Korb-Modular/02_FOLDER/05_Docs/BOM FOLDER Ver1.0.xlsx

BOM: FOLDER Ver1.0
Qty | Value | Device | Package | Parts | Description | Mouser
Resistors
9 | 100 | R-EU_R0603 | R0603 | R2, R4, R18, R23, R118, R158, R159, R160, R161 | RESISTOR, European symbol | 667-ERJ-3EKF1000V
3 | 475 | R-EU_R0603 | R0603 | R19, R62, R157 | RESISTOR, European symbol | 667-ERJ-3EKF4750V
1 | 680 | R-EU_R0603 | R0603 | R130 | RESISTOR, European symbol | 667-ERJ-3EKF6800V
10 | 1k | R-EU_R0603 | R0603 | R22, R26, R34, R49, R51, R81, R89, R95, R109, R114 | RESISTOR, European symbol | 667-ERJ-3EKF1001V
2 | 2k | R-EU_0204/7 | 0204/7 | R24, R55 | Tempco Resistor – 1% 3300ppm | e.g. THONK
6 | 2k | R-EU_R0603 | R0603 | R3, R33, R39, R46, R80, R96 | RESISTOR, European symbol | 667-ERJ-3EKF2001V
1 | 2,67k | R-EU_R0603 | R0603 | R141 | RESISTOR, European symbol | 667-ERJ-3EKF2671V
2 | 3k | R-EU_R0603 | R0603 | R41, R103 | RESISTOR, European symbol | 667-ERJ-3EKF3001V
6 | 4,7k | R-EU_R0603 | R0603 | R9, R36, R52, R65, R102, R112 | RESISTOR, European symbol | 667-ERJ-3EKF4701V
2 | 5,62k | R-EU_R0603 | R0603 | R152, R153 | RESISTOR, European symbol | 667-ERJ-3EKF5621V
1 | 6,8k | R-EU_R0603 | R0603 | R155 | RESISTOR, European symbol | 667-ERJ-3EKF6801V
21 | 10k | R-EU_R0603 | R0603 | R12, R13, R17, R25, R32, R35, R40, R42, R47, R63, R75, R79, R85, R87, R88, R92, R97, R98, R134, R135, R162, | RESISTOR, European symbol | 667-ERJ-3EKF1002V
11 | 15k | R-EU_R0603 | R0603 | R121, R131, R132, R142, R143, R144, R145, R146, R147, R148, R149 | RESISTOR, European symbol | 667-ERJ-3EKF1502V
2 | 18k | R-EU_R0603 | R0603 | R70, R77 | RESISTOR, European symbol | 667-ERJ-3EKF1802V
6 | 20k | R-EU_R0603 | R0603 | R14, R21, R48, R93, R94, R108 | RESISTOR, European symbol | 667-ERJ-3EKF2002V
2 | 22k | R-EU_R0603 | R0603 | R119, R127 | RESISTOR, European symbol | 667-ERJ-3EKF2212V
1 | 27k | R-EU_R0603 | R0603 | R151 | RESISTOR, European symbol | 667-ERJ-3EKF2702V
2 | 33k | R-EU_R0603 | R0603 | R128, R140 | RESISTOR, European symbol | 667-ERJ-3EKF3302V
2 | 47k | R-EU_R0603 | R0603 | R20, R86 | RESISTOR, European symbol | 667-ERJ-3EKF4702V
3 | 56k | R-EU_R0603 | R0603 | R154, R156, R164 | RESISTOR, European symbol | 667-ERJ-3EKF5602V
1 | 68k | R-EU_R0603 | R0603 | R125 | RESISTOR, European symbol | 667-ERJ-3EKF6802V
30 | 100k | R-EU_R0603 | R0603 | R1, R6, R10, R15, R29, R31, R43, R44, R50, R54, R66, R67, R74, R76, R82, R84, R91, R99, R101, R110, R116, R124, R126, R129, R136, R137, R138, R139, R165, R166 | RESISTOR, European symbol | 667-ERJ-3EKF1003V
2 | 130k | R-EU_R0603 | R0603 | R53, R113 | RESISTOR, European symbol | 667-ERJ-3EKF1303V
5 | 200k | R-EU_R0603 | R0603 | R27, R37, R56, R57, R115, | RESISTOR, European symbol | 667-ERJ-3EKF2003V
2 | 470k | R-EU_R0603 | R0603 | R61, R107 | RESISTOR, European symbol | 667-ERJ-3EKF4703V
10 | 1M | R-EU_R0603 | R0603 | R8, R28, R30, R38, R45, R69, R72, R73, R78, R111 | RESISTOR, European symbol | 667-ERJ-3EKF1004V
2 | 10M | R-EU_R0603 | R0603 | R68, R100 | RESISTOR, European symbol | 667-ERJ-3GEYJ106V
Potentiomenters
1 | 50k | EVUF2A | EVUF | SHAPE | 9 mm Square Rotary Potentiometers | e.g. Thonk
7 | 100k | EVUF2A | EVUF | COARSE, COARSE_OSC1, COARSE_OSC2, FOLD_RANGE, OSC_MIX, PW_OSC1, PW_OSC2 | 9 mm Square Rotary Potentiometers | e.g. Thonk
Trimmer
2 | 100 | R-TRIMM64W | RTRIM64W | R16, R58 | Trimm resistor | 72-T93YA-100
1 | 1k | R-TRIMM64W | RTRIM64W | R133 | Trimm resistor | 72-T93YA-1K
4 | 10k | R-TRIMM64W | RTRIM64W | R5, R7, R83, R90 | Trimm resistor | 72-T93YA-10K
6 | 100k | R-TRIMM64W | RTRIM64W | R11, R60, R64, R71, R104, R105 | Trimm resistor | 72-T93YA-100K
1 | 50k | R-TRIMM64W | RTRIM64W | R120 | Trimm resistor | 72-T93YA-50K
2 | 1M | R-TRIMM64W | RTRIM64W | R59, R106 | Trimm resistor | 72-T93YA-1M
Capacitors
2 | 4,7p | C-EUC0603 | C0603 | C18, C22 | CAPACITOR, European symbol | 81-GQM1885C2A4R7BB01
2 | 10pf | C-EUC0603 | C0603 | C4, C32 | CAPACITOR, European symbol | 81-GRM39C100D50
6 | 100pf | C-EUC0603 | C0603 | C3, C9, C11, C17, C19, C21 | CAPACITOR, European symbol | 81-GRM39C101J50
2 | 1n | C-EUC0603 | C0603 | C5, C24 | CAPACITOR, European symbol | 81-GRM39C102J50
2 | 2n | C-EUC0603 | C0603 | C14, C27 | CAPACITOR, European symbol | 81-GRM1885C1H202JA1D
2 | 4,7n | C-EUC0603 | C0603 | C6, C20 | CAPACITOR, European symbol | 81-GRM1885C1H472JA1D
16 | 100n | C-EUC0603 | C0603 | C1, C2, C8, C15, C16, C30, C31, C23, C25, C26, C35, C36, C39, C40, C41, C42 | CAPACITOR, European symbol | 81-GRM188R71E104JA1J
4 | 1uf | C-EUC0603 | C0603 | C12, C13, C28, C29 | CAPACITOR, European symbol | 81-GRM18R61A105KA61J
1 | 10u | C-EUC1210 | C1210 | TANT_C43 | CAPACITOR, European symbol | 581-TPST106K006R1000
6 | 10uf | CPOL-EUA | PANASONIC_A | C7, C10, C33, C34,C37, C38 | POLARIZED CAPACITOR, European symbol | 647-UWX1C100MCL2
Semiconductor
36 | 1N4148 | DIODE-SOD123 | SOD123 | D1, D2, D3, D4, D5, D6, D7, D8, D9, D10, D11, D12, D13, D14, D15, D16, D17, D18, D19, D20, D21, D22, D23, D24, D25, D26, D27, D28, D29, D30, D31, D32, D33, D34, D35, D36 | DIODE | 621-1N4148W-F
2 | 1N5819HW | DIODE-SOD123 | SOD123 | D37, D38 | DIODE | 621-1N5819HW-F
2 | MMBF5457 | MMBFJ3 | SOT23 | Q1, Q2 | N-Channel RF Amplifier | 512-MMBF5457
3 | BC847 | BC847 | SOT23 | T1, T2, T3 | NPN TRANSISTOR | 771-BC847B-T/R
2 | SSM2212 | SSM2212 | SSM2212 | U1, U3 | OP AMP | 584-SSM2212RZ
2 | TL071D | TL071D | SO08 | IC3, IC14 | OP AMP | 511-TL071CDT
7 | TL072D | TL072D | SO08 | IC1, IC2, IC6, IC10, IC11, IC13, IC19 | OP AMP | 511-TL072CDT
6 | TL074D | TL074D | SO14 | IC4, IC7, IC9, IC12, IC16, IC20 | OP AMP | 511-TL074IYDT
2 | 74LS595D | 74LS595D | SO16 | IC21, IC22 | 8-bit SHIFT REGISTER, output latch | 595-CD74HC595M
2 | 4051D | 4051D | SO16 | IC8, IC17 | 8-channel ANALOG MULTIPLEXER | 771-HEF4051BTD-T
2 | LM13700M | LM13700M | SO16 | IC5, IC15 | National Dual OTA with buffers. | 926-LM13700MX/NOPB
1 | ATTINY85-20SU | ATTINY85-20SU | SOIC127P798X216-8N | U2 | 8-bit Microcontroller with In-System Programmable Flash | 556-ATTINY85-20SU
1 | REG1117 | REG1117 | SOT223 | IC25 | 800mA and 1A Low Dropout (LDO) Positive Regulator | 595-REG1117-5
2 | PTCSMD | PTCSMD | PTC-1206 | P1, P2 | Resettable Fuse PTC | 504-PTS120616V025
Opto
8 | LED | LED3MM | LED3MM | LED1, LED2, LED3, LED4, LED9, LED10, LED11, LED12 | LED | 606-4300F5LC
Mechanical
1 | PCB Ver: 1.0 |  |  |  |  | www.Korb-Modular.com
1 | Panel |  |  |  |  | www.Korb-Modular.com
2 | SPDT Switch | SWITCH-SPDTPTH | SWITCH-SPDT | S1, S2 | SPDT Switch | 108-0051-EVX
2 | Momentary Switch | TAC_SWITCHPTH | TACTILE-PTH | WAVE_OSC1, WAVE_OSC2 | Momentary Switch | 612-TL1105SP-250
2 | Momentary Switch CAP | Cap | Switch Bezels / Switch Caps | WAVE_OSC1, WAVE_OSC2 | Switch Bezels / Switch Caps 9 X 5MM RND CAP BLK | 612-1R-BK
1 | Arduino Flash | MA06-1 | MA06-1 | SV2 | PIN HEADER | 649-68002-106HLF
1 | M05X2PTH | M05X2PTH | AVR_ICSP | JP2 | Header 5x2 | 649-67996-410HLF
1 | Expander | 2516- | 16Pin Male Straight | EXPANDER | WR-BHD 2.54mm Box 16Pin Male Straight | 710-61201621621
8 | CV_Control | WQP-PJ301M-12_JACK | WQP-PJ301M-12_JACK | CV_CONTROL, CV_OSC1, CV_OSC2, FOLD , MAIN_CV, MIX, OSC1 , OSC2 | Thonkiconn Jacks | e.g. THONK
