Korb-Modular/02_FOLDER/02_Panel/Folder_13032017.pdf

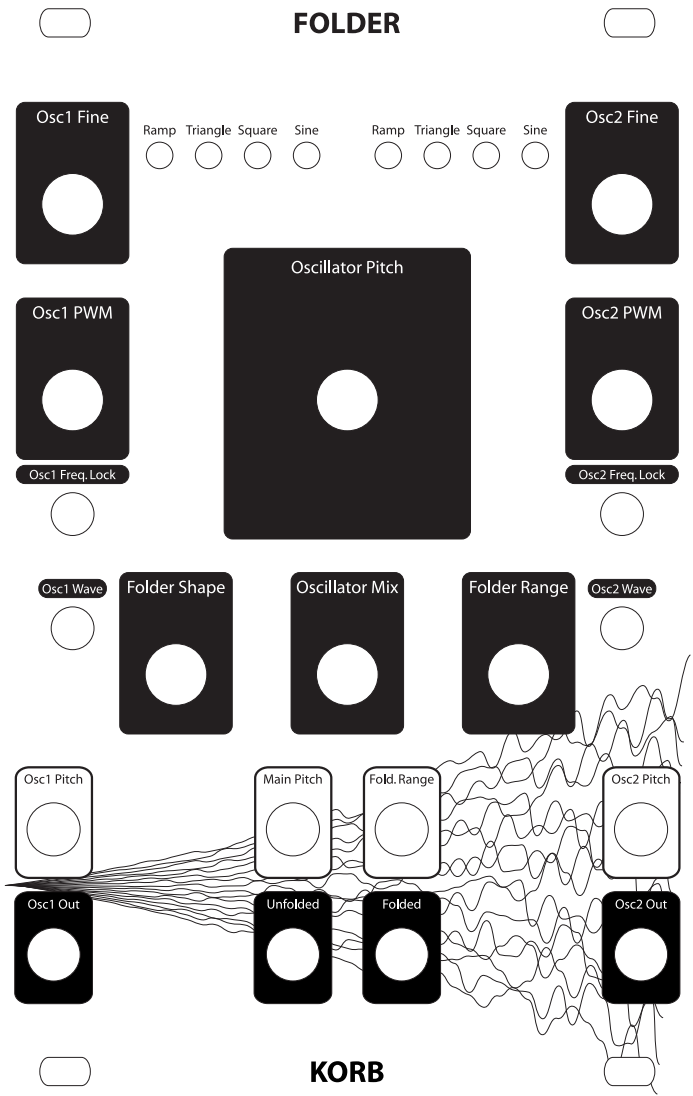
[picture p1: page 1]
