Korb-Modular/02_FOLDER/05_Docs/FOLDER Build Guid.pdf

## FOLDER Build Guide

## Assembly

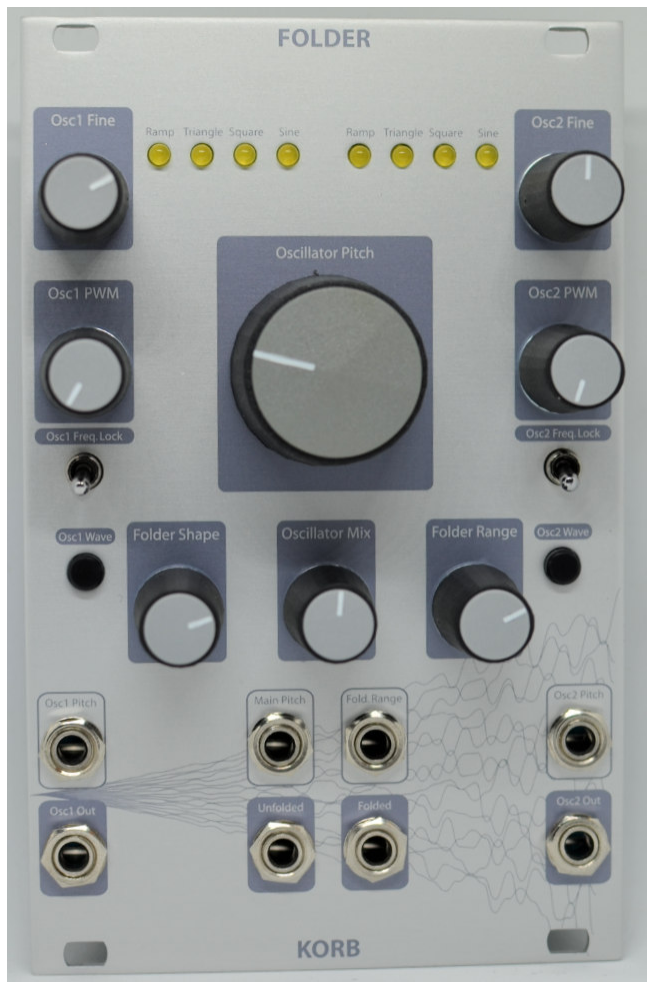
[picture p2: figure]

FOLDER by Korb-Modular

PCB Ver. : 1.0

Doc Ver. : 1.0

Date: 19.04.2017

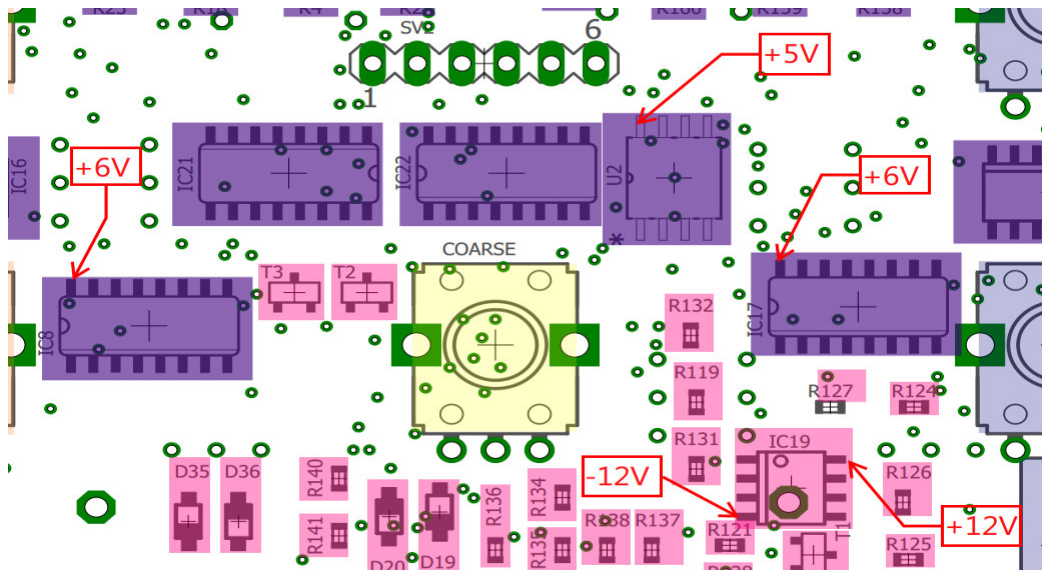
[picture p3: figure]

### 1. Step:

Start with assembling of the the Power Supply.

Don't forget R3,R33,R39,R96 (Bottom side)

Verfify if the voltages are correct

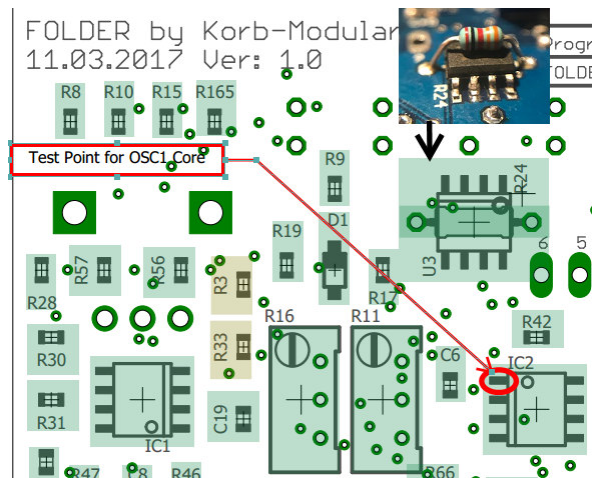
[picture p4: figure]

### 2. Step:

Assemble the Parts for OSC1 Core.

Mount R24 with a direct thermal contact to U3

Power up the module and check on the testspoints if the

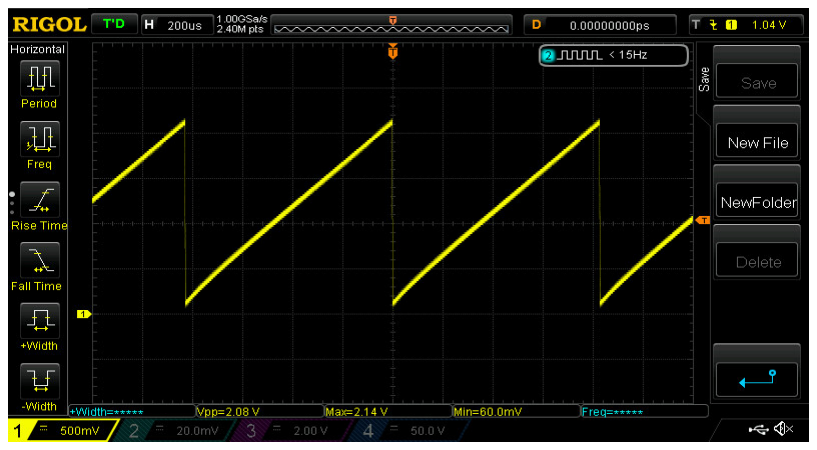
[picture p5: figure]

ramp core is working

Tip: Do not assemble

the Coarse_OSC2 pot

yet. For the functional

tests it's not needed.

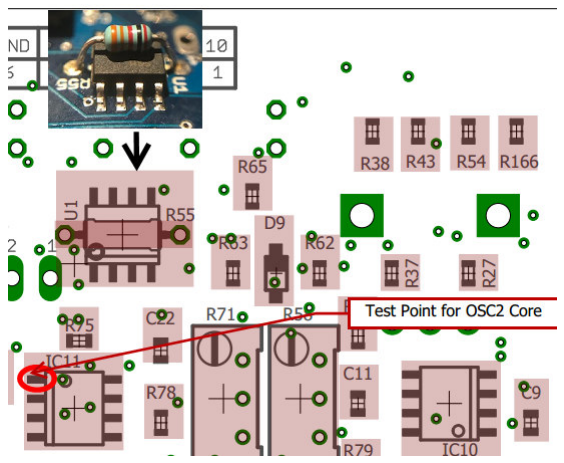
[picture p6: figure]

### 3. Step:

Assemble the Parts for OSC2 Core.

Mount R55 with a direct thermal contact to U1

Power up the module and check on the testspoint if the

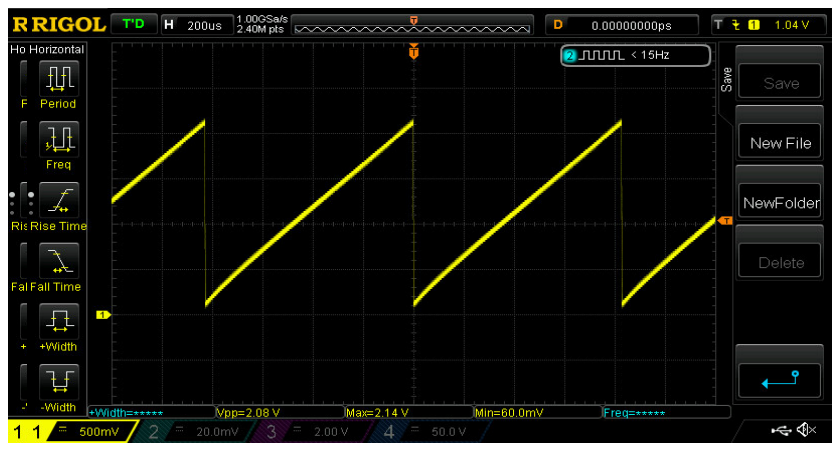
[picture p7: figure]

ramp core is working

Tip: Do not assemble

the Coarse_OSC2 pot

yet. For the functional

tests it's not needed.

## Assembly

Before you start:

Folder is an advanced project and not recommend as the first SM T project. In addition to the usual

electronic equipment a scope is needed. I recommend a hot air gun instead of an soldering iron for the

SM T Parts. Please read the entire doc before starting the project.

### 3. Step:

Assemble the parts of the Waveshaper section of OSC1.

Verify with a scope if the waveforms are available at the

testpoints.

Trimming of the Waveforms OSC1

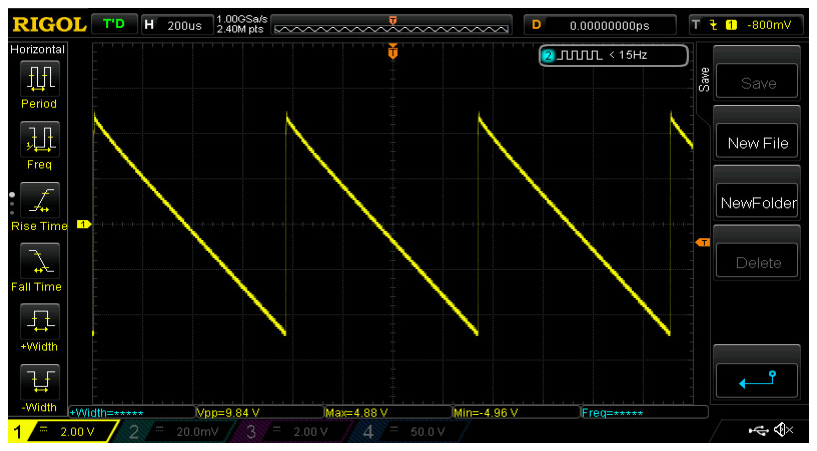
[picture p8: figure]
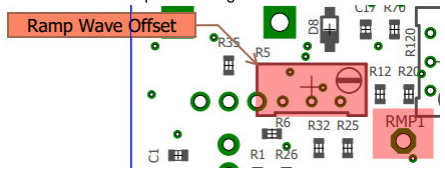
[picture p9: figure]

Use R5 to center the Ramp wave to ground

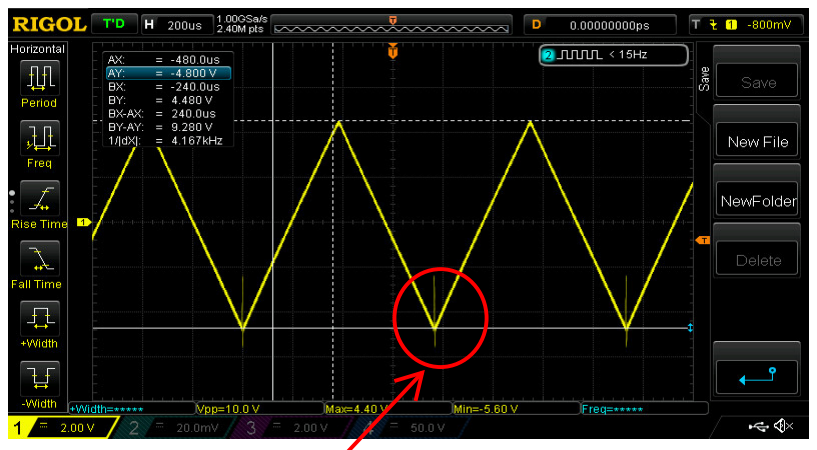
[picture p10: figure]

Use R7 to center the triangle wave to ground

Re-Adjust R5 if the triangle wave looks not proper

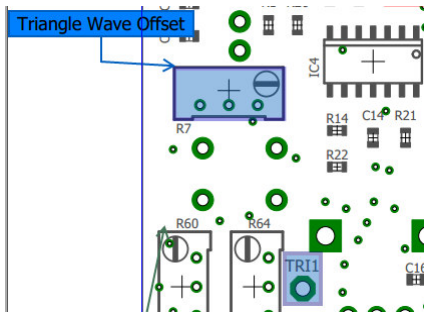
[picture p11: figure]
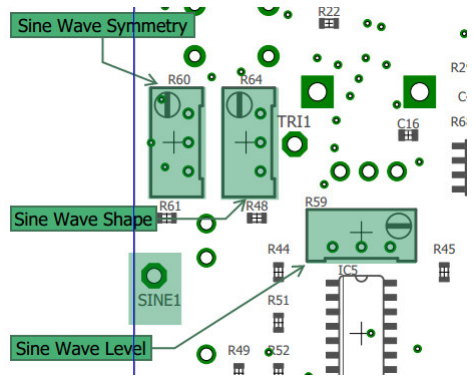
[picture p12: figure]
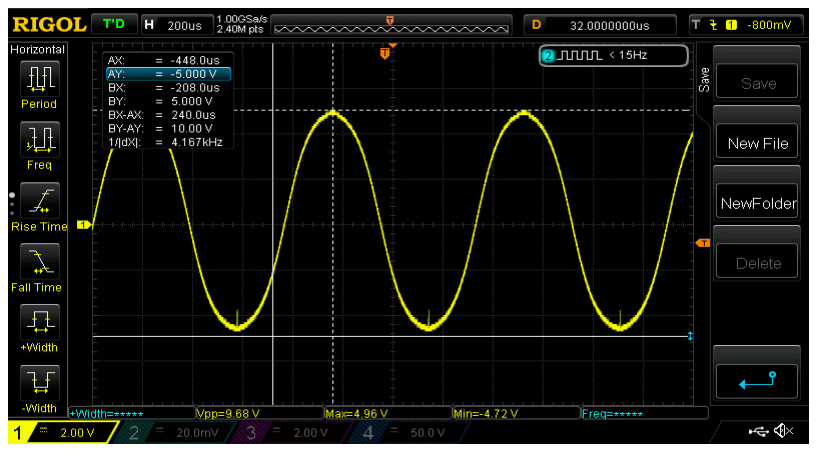
[picture p13: figure]

Use R60/R64 to trim the Sine wave to a nice shape

Use R59 to adjust the Level (10Vpp)

## Assembly

Glitches are not audible

## Assembly

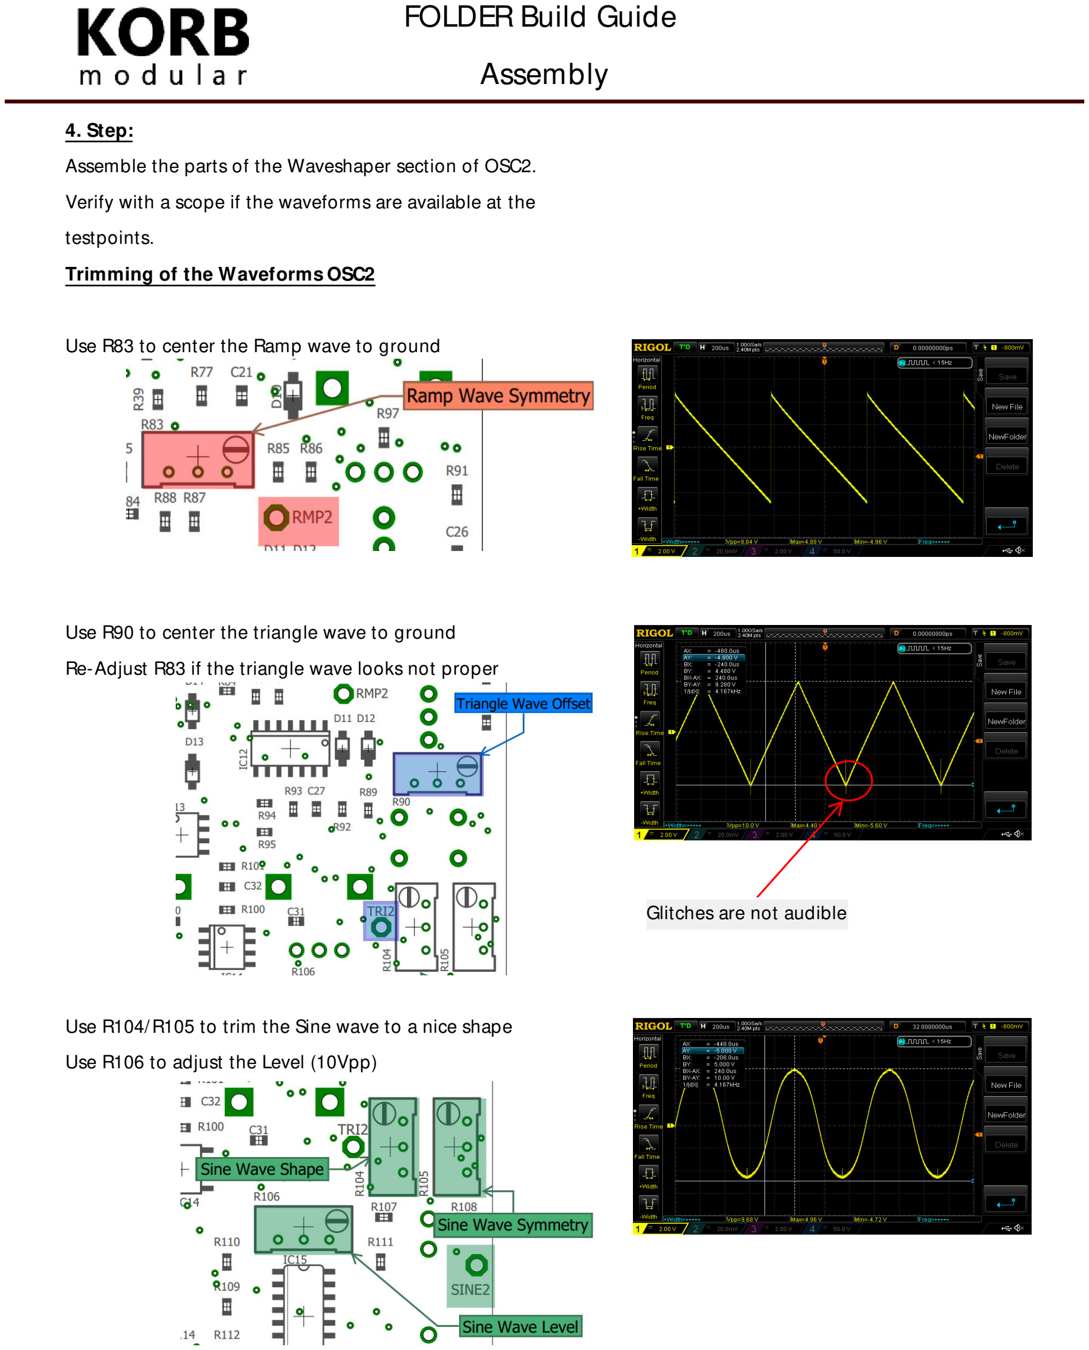
[picture p14: page 4]

### 4. Step:

Assemble the parts of the Waveshaper section of OSC2.

Verify with a scope if the waveforms are available at the

testpoints.

Trimming of the Waveforms OSC2

Use R83 to center the Ramp wave to ground

Use R90 to center the triangle wave to ground

Re-Adjust R83 if the triangle wave looks not proper

Use R104/R105 to trim the Sine wave to a nice shape

Use R106 to adjust the Level (10Vpp)

Glitches are not audible

### 5. Step:

Assemble all parts for the digital controlled wave switch.

If the µC is already flashed, you do not need the pin 1 x 6

row.

Double check the orientation of the ICs.

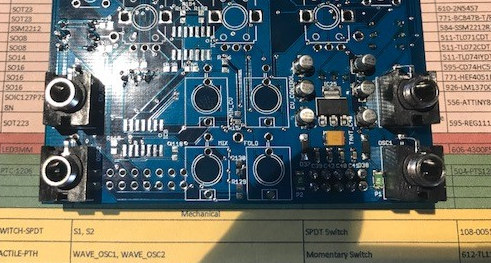
[picture p15: figure]

### 1. Tip:

For a better alignment of the LEDs, solder the left- and

rightmost Jacks on the PCB.

### 2. Tip

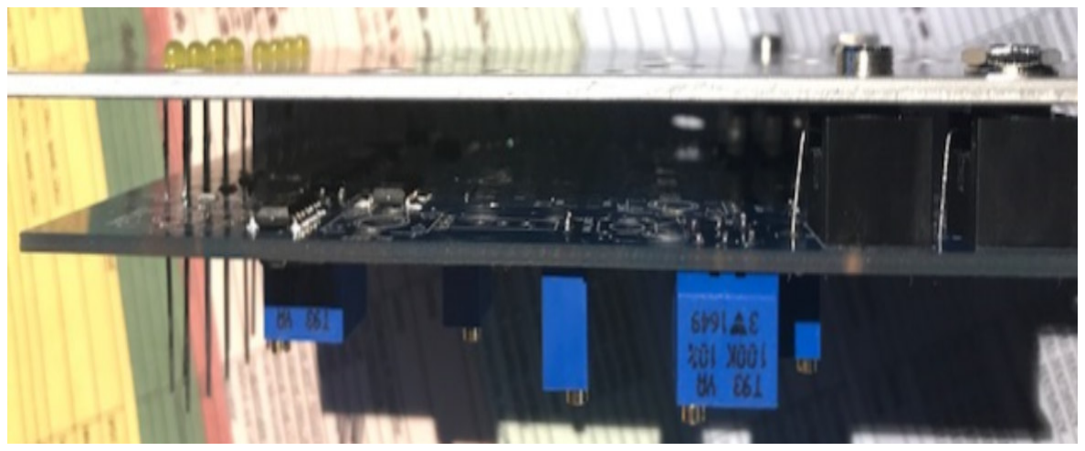
[picture p16: figure]

Do not solder the tactile switches for the waveform switch.

For a short function test it's enough to snap them in.

Power up the module and check if the waveforms / LEDs

cycling accordingly.

## Assembly

### 6. Step:

Assemble all parts for the Oscillator mixer section.

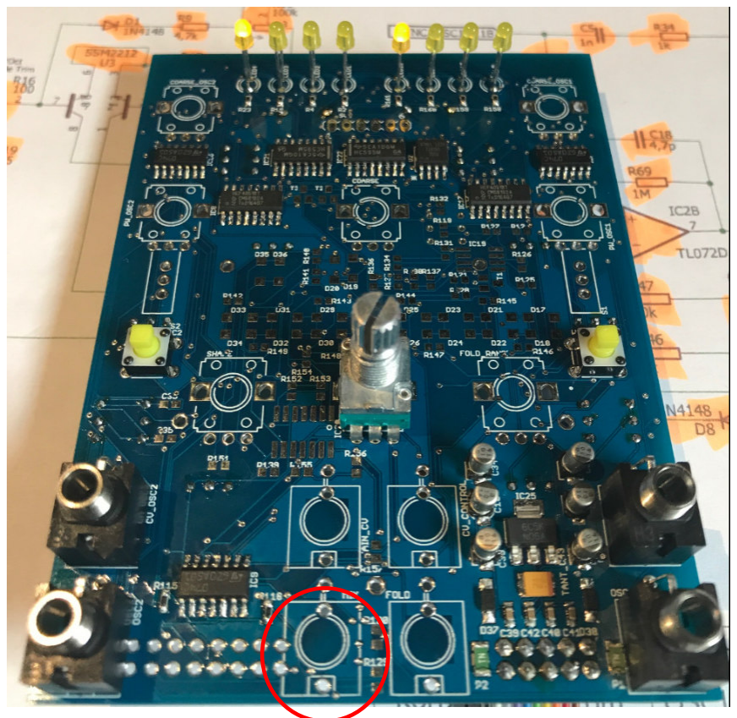
[picture p17: figure]

Power up the module and set different waveforms for

OSC1 / OSC2.

Check at the Mixer-Out if the output is changing according

the movement of the OSC-Mix pot.

CCW=>OSC1

CW => OSC2

Tip:

Do not solder the OSC-Mix pot, yet.

For a quick function test, it's enough to snap it in.

Mixer-Out

### 7. Step:

Assemble all parts for the wavfolder section. For the function

test the Mix-Pot and the wave switching buttons are also

needed

Tip:

Do not solder the pots/buttons yet. For the function test its

enough to just snap them in.

Power up the module and set the waveform of OSC1 to Sine.

Turn the Mixer-Port fully CCW , the Range-Pot and

Shape-Pot to 12 o'clock.

Check the waveform at the Fold-Out.

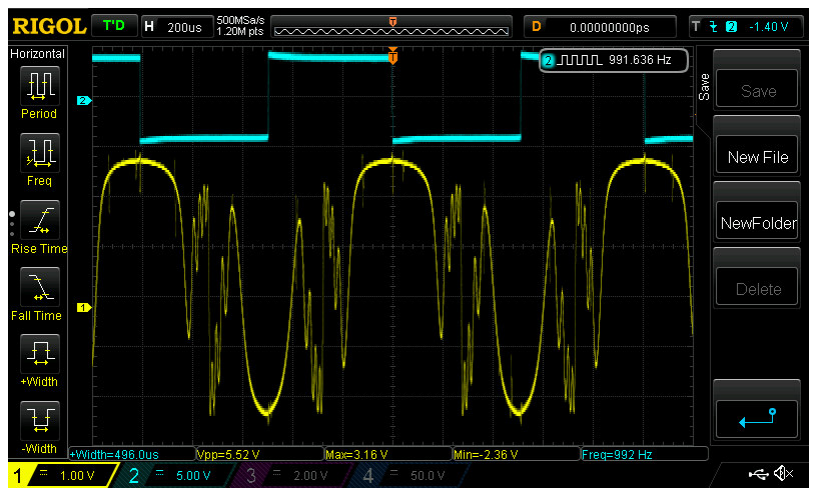
[picture p18: figure]

If everything is set up in the correct way you should see

a folded wave.

Play with the Shape-Pot and the Waveform will folded in a

different way.

Repeat the test for OSC2. Therefore set the waveform to

Triangle or Sine and turn the Mix-Pot fully CW

Tip:

The wavefolder works best with a Triangle or Sinewave.

If you mix OSC1/OSC2 use the Freq.Lock Switch for a better

result.

## Assembly

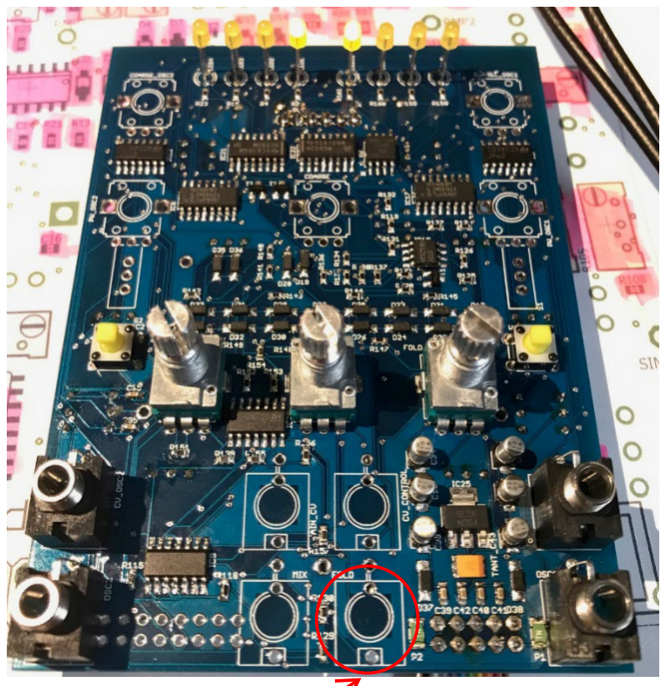
[picture p19: figure]

Fold-Out

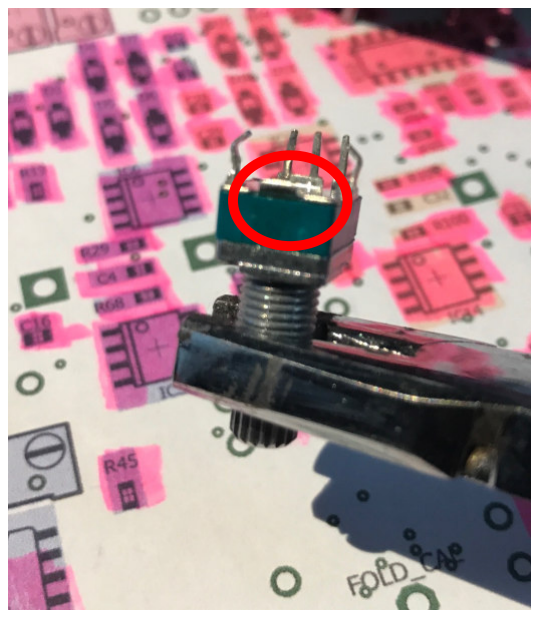
[picture p20: figure]

### 8. Step:

Assemble all pots, jacks, buttons ands switches.

Some pots have a small metal thing on the bottom side, be

careful with it. Make sure that there is no short circuit with

the vias of the board when you solder the pots. To be on the

safe side, cut it off.

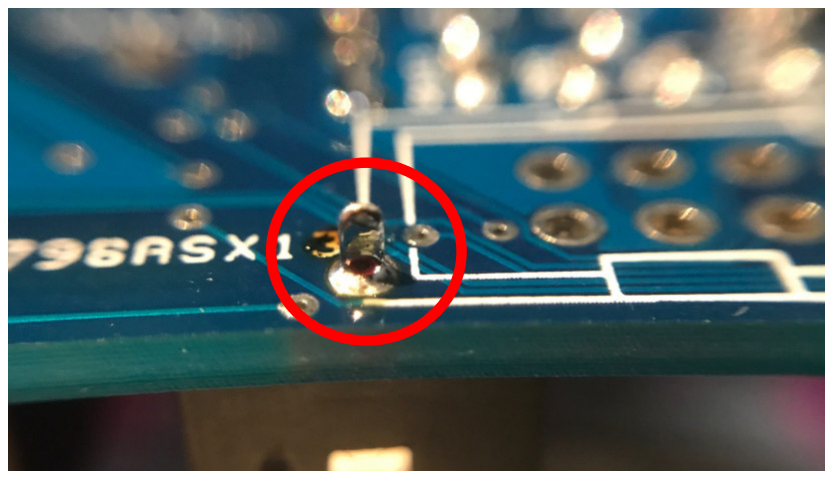
[picture p21: figure]

As last, solder the Expander Port. Therefore you must trim

the pins of the OSC-Out and the Mix-Out jacks a little bit.

KNOWN ISSUE:

There is a know production issue with Ver. 1.0 of the PCBs.

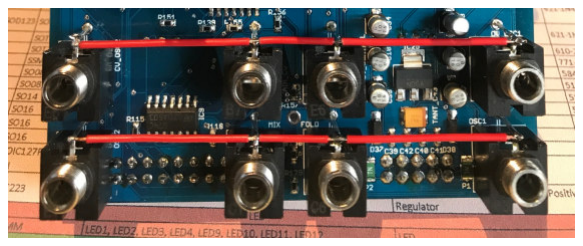
[picture p22: figure]

This leads to an unstable pitch of OSC1.

Luckily, the fix is very easy. Just connect all GND pins of the

Jacks for the upper and lower row. There is no need to

connect the rows to each other.

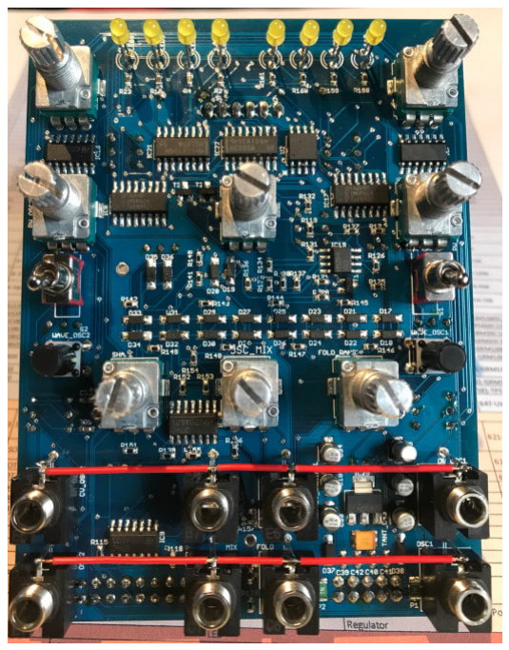
[picture p23: figure]

Done.

## Assembly

Board Map | Top

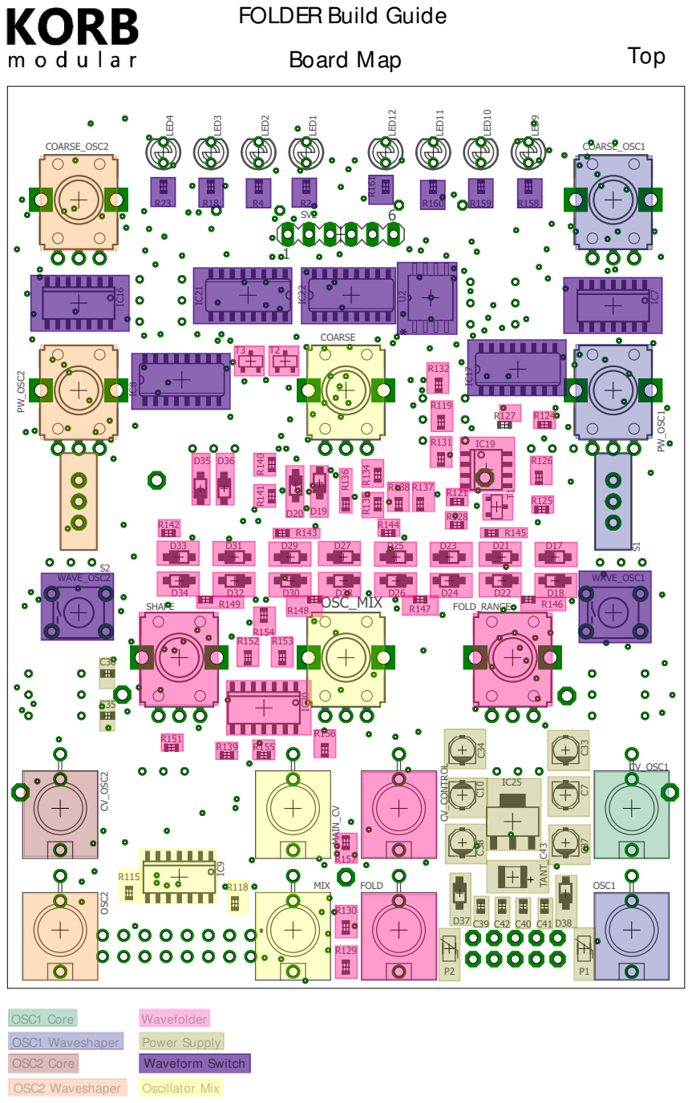
[picture p24: page 8]

Board Map | Bottom

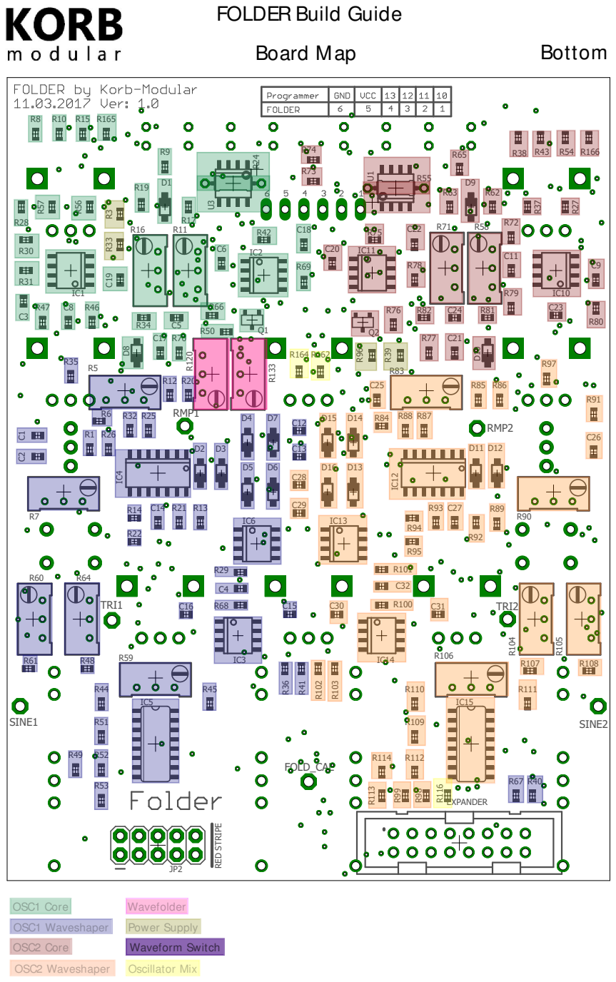
[picture p25: page 9]

## FOLDER build guide

## Calibration points

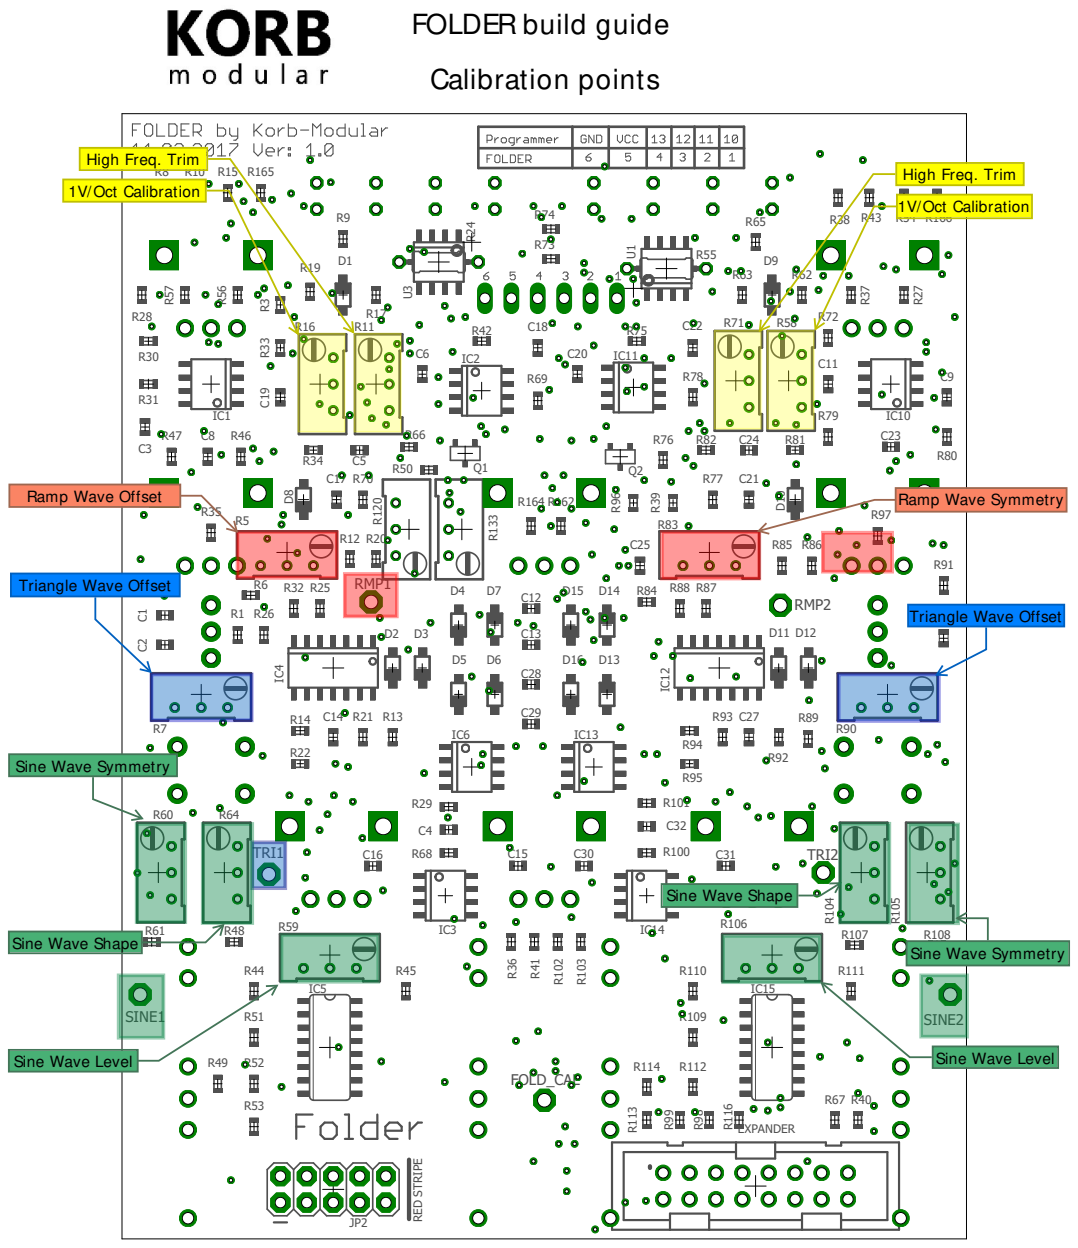
[picture p26: page 10]
