Korb-Modular/02_FOLDER/(commit log)

2017-01-15 init Version
    Folder Osc init version
    [BOM FOLDER Ver0.2 12092016.xlsx]
2017-01-16 Corrction of Mouser PN for C4,C32
    [BOM FOLDER Ver0.2 12092016.xlsx]
